Gshano/VCFG-Design/Breadboard Implementation.JPEG

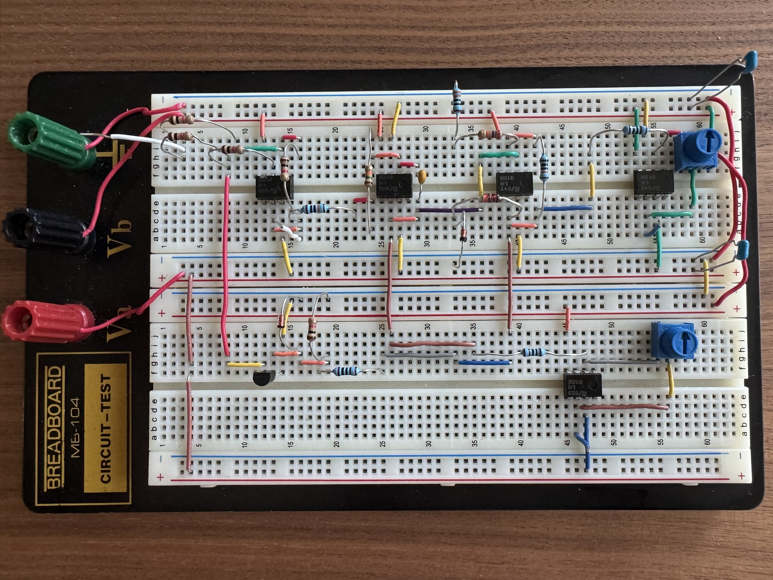
Breadboard Implementation.JPEG
