Gshano/VCFG-Design/MultiSIM Schematic.png

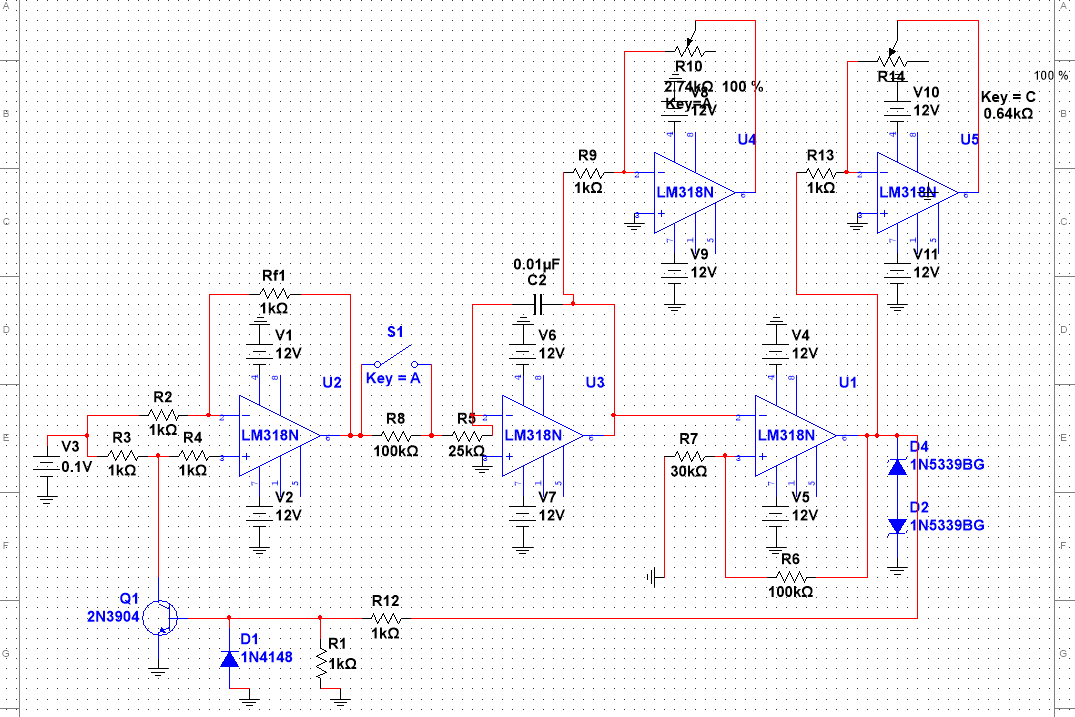
MultiSIM Schematic.png
