Gshano/VCFG-Design/(list of files, drawings)

Other design files:
VCFG-FinalBuild.ms14
